BryantSuen/ultrasonic_distance/report/预习报告.pdf

# 预习报告

王晨宇孙博然

2021 年 6 月 27 日

## 1 发送电路

### 1.1 电路图

电路初步设计如图所示


图 1: 发送电路图

采用摆率较大的 LF347 放大器，同相放大，放大倍数设置为 3。LF347 需要接 10V 电源。

1.2 仿真结果 | 预习报告 | 2 接收电路

### 1.2 仿真结果


图 2: 发送电路仿真结果

## 2 接收电路

如图所示

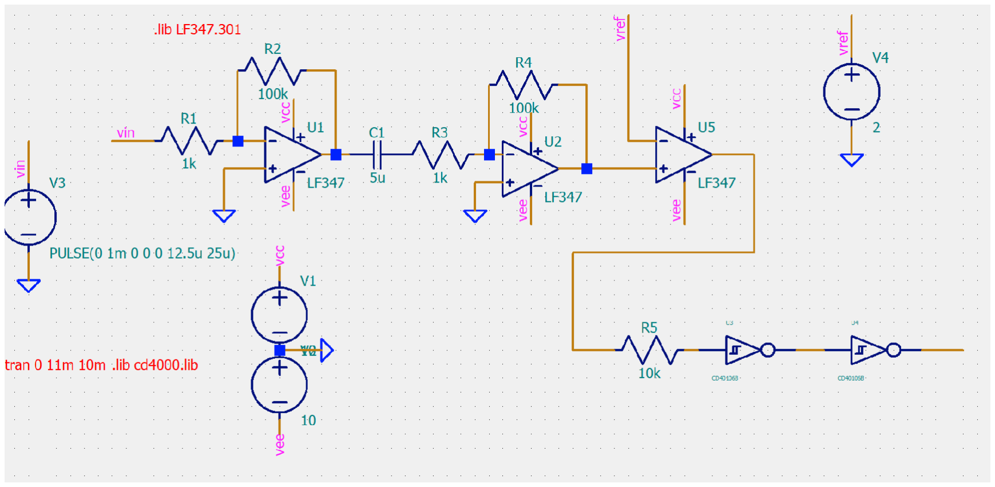
[picture p24: figure]

图 3: 接收电路图

考虑到增益 LF347 增益带宽积，采用两级反相放大，中间添加电容去除直流分量。比较器 Vref 暂时定位 2V，之后连接匹配整形电路。

2.1 仿真结果 | 预习报告 | 3 脉冲产生、计数与显示

### 2.1 仿真结果


图 4: 接收电路仿真结果

CD40106 饱和电压设置 3.3V(与 fpga 相连接)。

## 3 脉冲产生、计数与显示

### 3.1 电路图


图 5: 脉冲产生、计数与显示电路

3.2 仿真结果 | 预习报告 | 3 脉冲产生、计数与显示

### 3.2 仿真结果

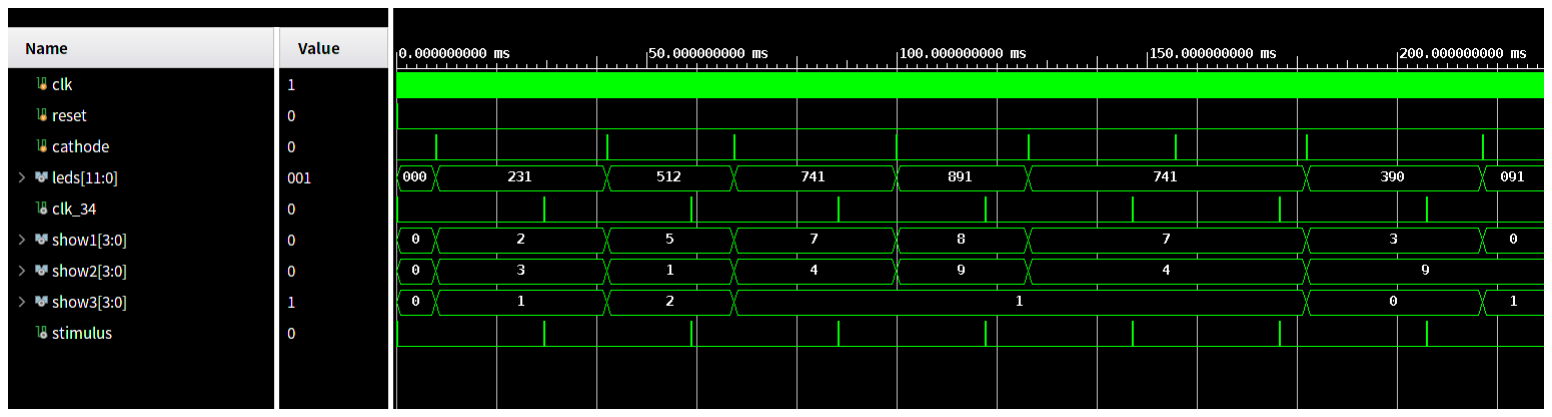
[picture p25: figure]

图 6: 仿真结果
