BryantSuen/ultrasonic_distance/digital_design/sources_1/new/schematic.pdf

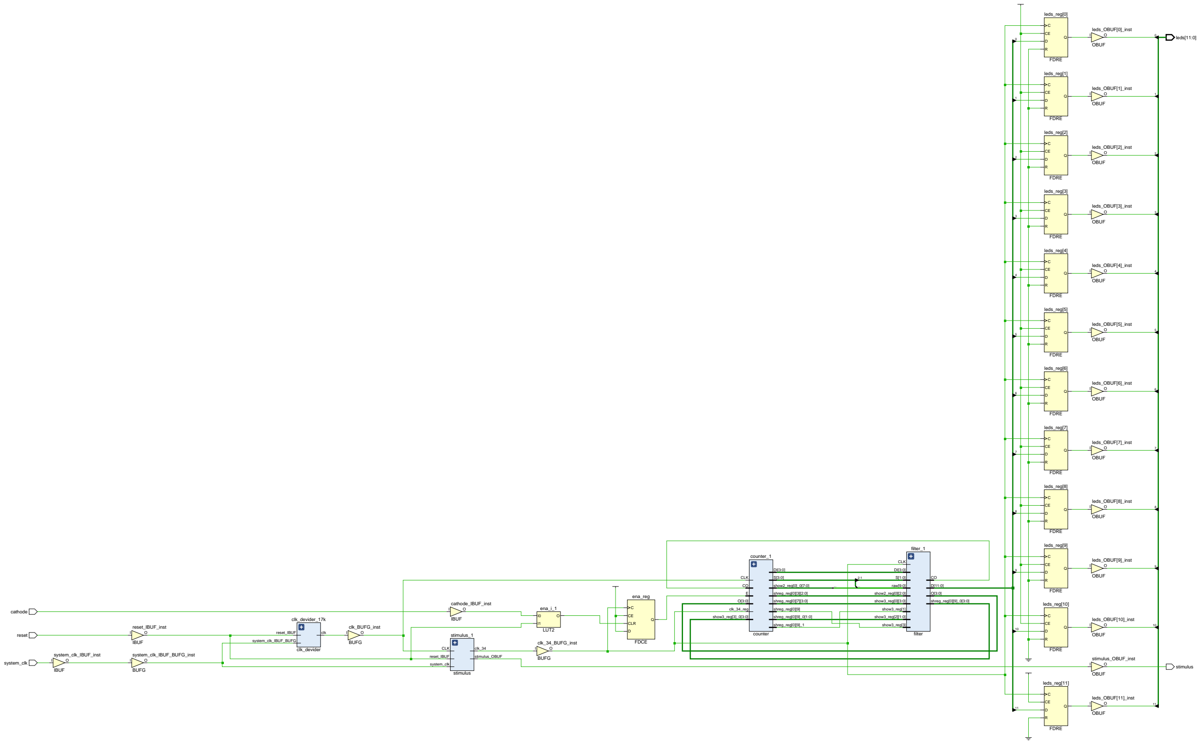
[picture p26: figure]
cathode; reset; system_clk; system_clk_IBUF_inst; IBUF I; reset_IBUF_inst; system_clk_IBUF_BUFG_inst; BUFG I; clk_devider_17k; clk_devider; reset_IBUF; clk; system_clk_IBUF_BUFG; clk_BUFG_inst; cathode_IBUF_inst; stimulus_1; stimulus; CLK; clk_34; stimulus_OBUF; ena_i_1; LUT2; clk_34_BUFG_inst; ena_reg; FDCE; C CECLR D; counter_1; counter; clk_34_reg; S[3:0] show2_reg[0]_0[7:0]; show3_reg[3]_0[3:0]; shreg_reg[0][3][2:0] shreg_reg[0][7][3:0] shreg_reg[0][9] shreg_reg[0][9]_0[1:0] shreg_reg[0][9]_1; filter_1; filter; shreg_reg[0][9]_0[3:0]; leds_reg[0]; FDRE; C CEDR; leds_reg[1]; leds_reg[2]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

raw[9:0] show2_reg[0][2:0] show3_reg[0][3:0] show3_reg[1] show3_reg[2][1:0] show3_reg[3]
