BryantSuen/ultrasonic_distance/报告/assets/图表1电路设计框图.png

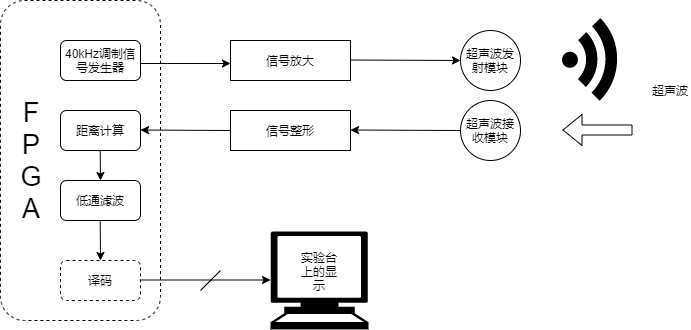
报告/assets/图表1电路设计框图.png
