BryantSuen/ultrasonic_distance/报告/assets/图表3发射电路仿真信号波形.png

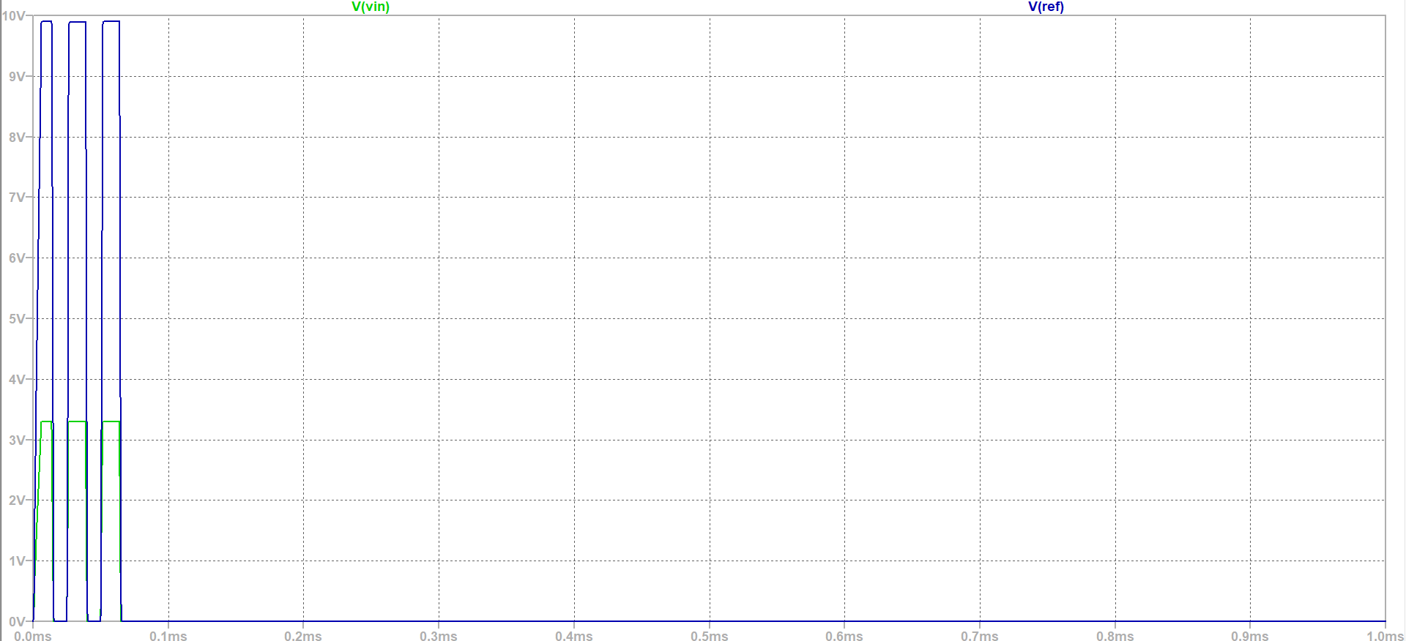
报告/assets/图表3发射电路仿真信号波形.png
