BryantSuen/ultrasonic_distance/报告/assets/图表5经过两级放大的信号（绿）以及通过整形的信号（蓝）.png

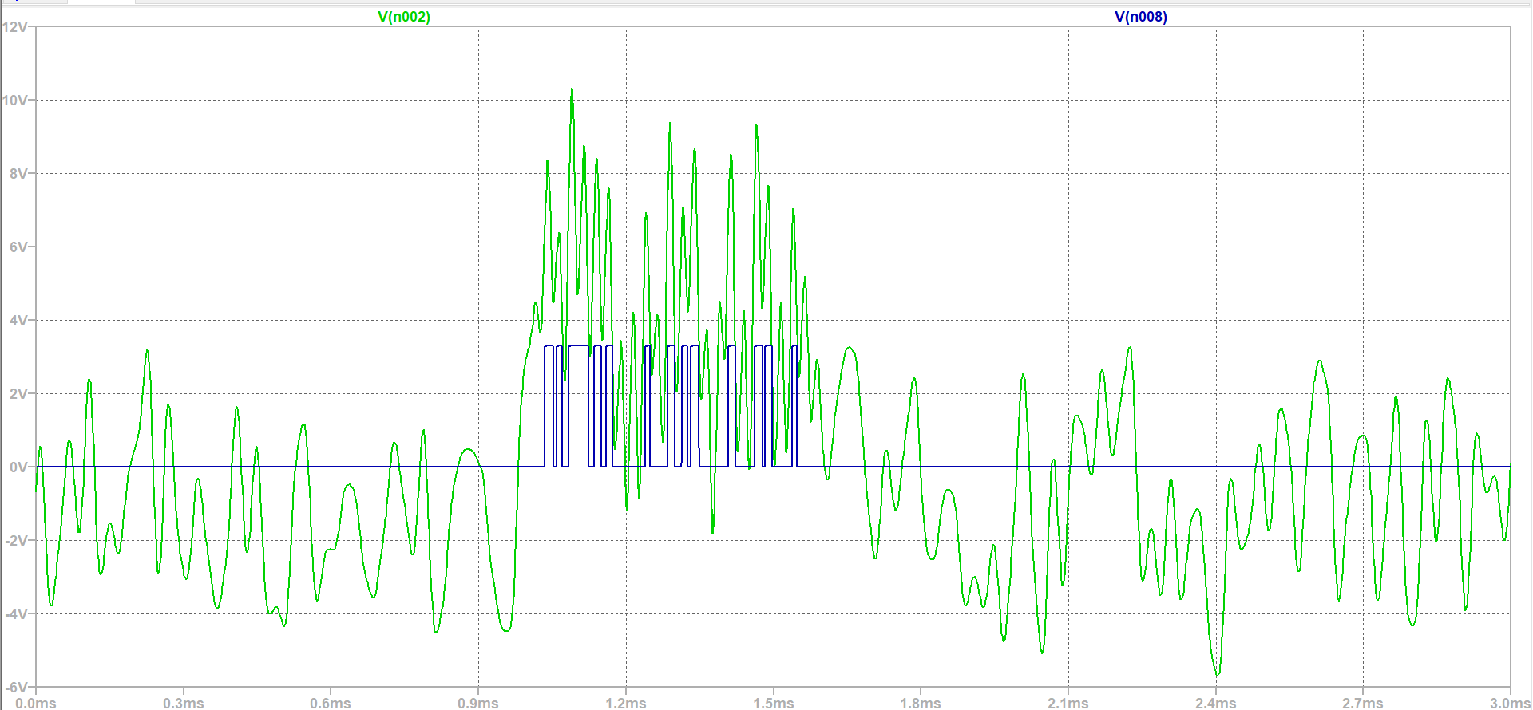
报告/assets/图表5经过两级放大的信号（绿）以及通过整形的信号（蓝）.png
