BryantSuen/ultrasonic_distance/报告/assets/图表8脉冲调制模块.jpg

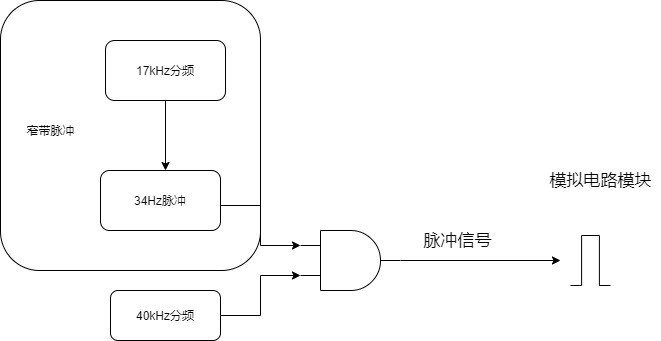
报告/assets/图表8脉冲调制模块.jpg
