BryantSuen/ultrasonic_distance/报告/assets/图表10功能前仿.png

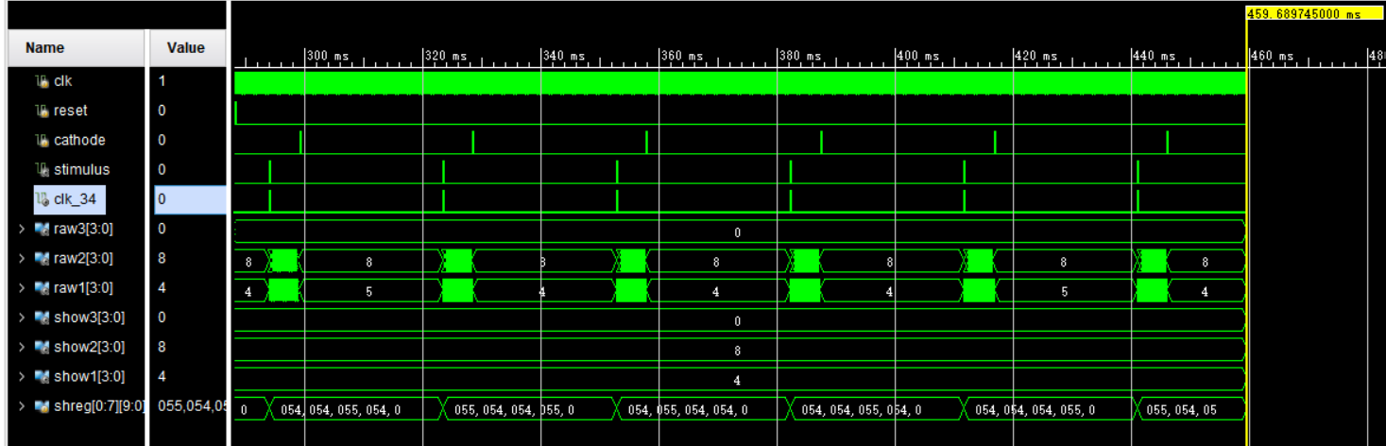
报告/assets/图表10功能前仿.png
