BryantSuen/ultrasonic_distance/报告/assets/图表12 数字电路资源占用情况.png

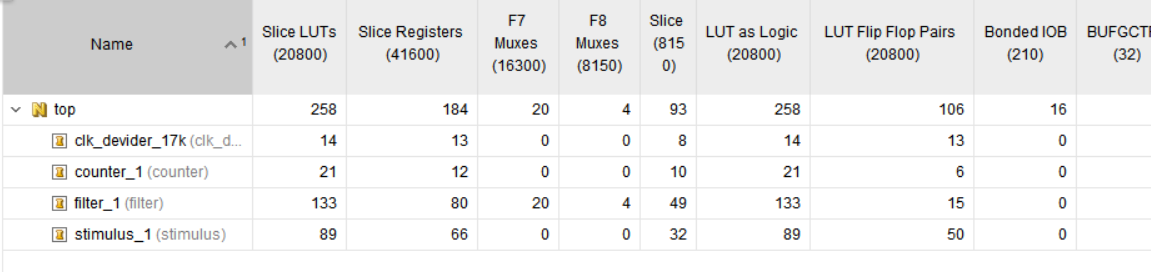
报告/assets/图表12 数字电路资源占用情况.png
