BryantSuen/ultrasonic_distance/报告/assets/图表13发射波形.png

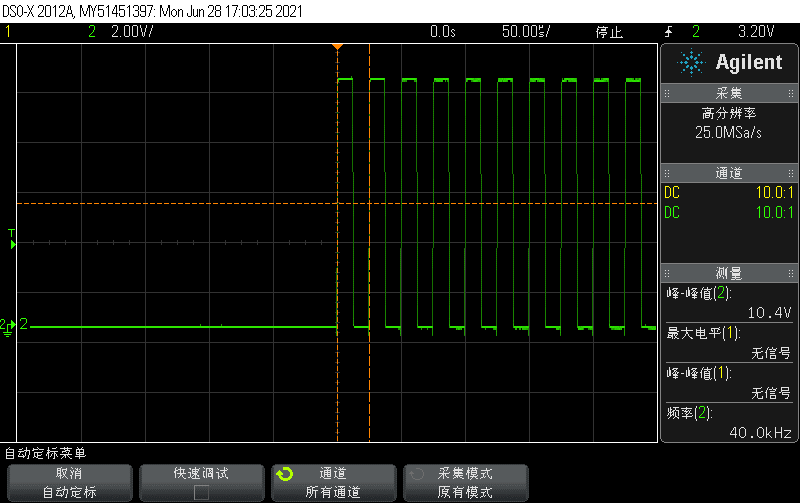
报告/assets/图表13发射波形.png
