BryantSuen/ultrasonic_distance/报告/assets/图表14回波放大.png

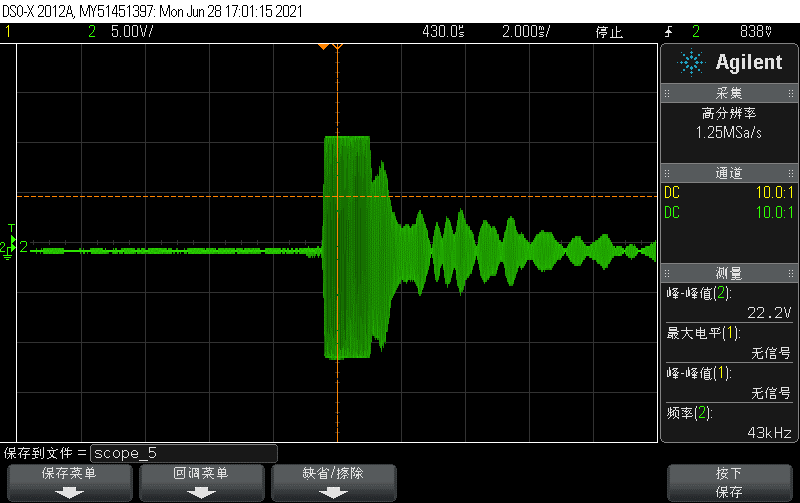
报告/assets/图表14回波放大.png
