BryantSuen/ultrasonic_distance/报告/assets/图表15整形波形.png

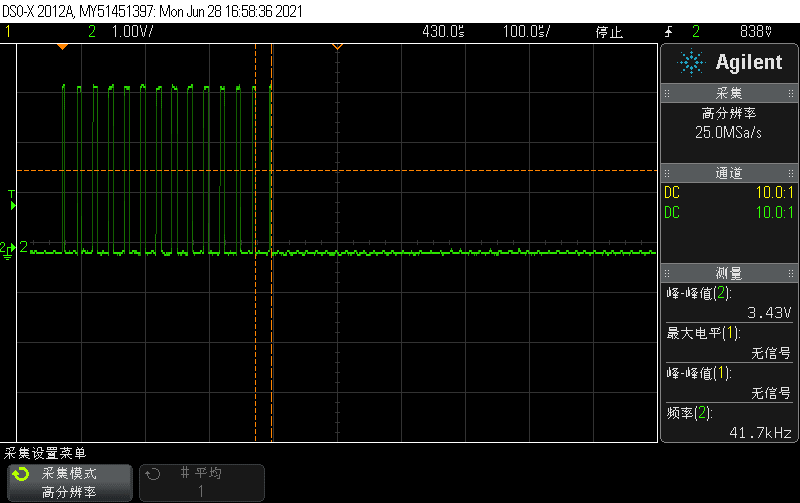
报告/assets/图表15整形波形.png
