BryantSuen/ultrasonic_distance/报告/assets/图表16过比较器(输入FPGA的最终波形).png

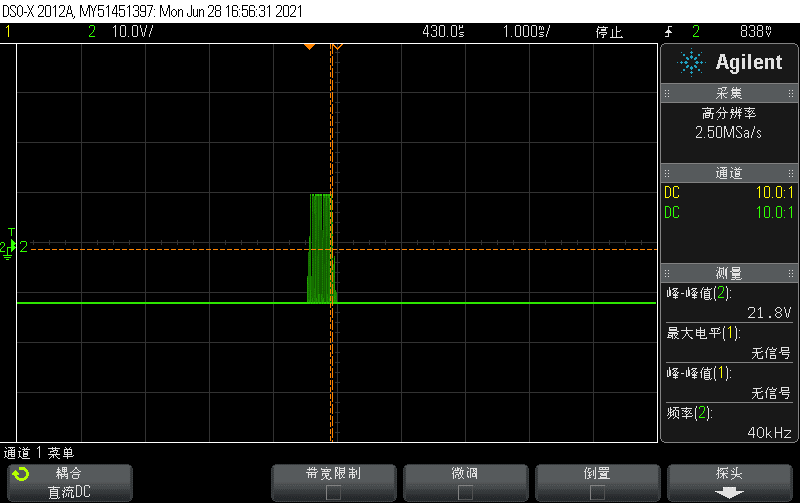
报告/assets/图表16过比较器(输入FPGA的最终波形).png
