BryantSuen/ultrasonic_distance/报告/assets/图表17 50cm显示情况.jpg

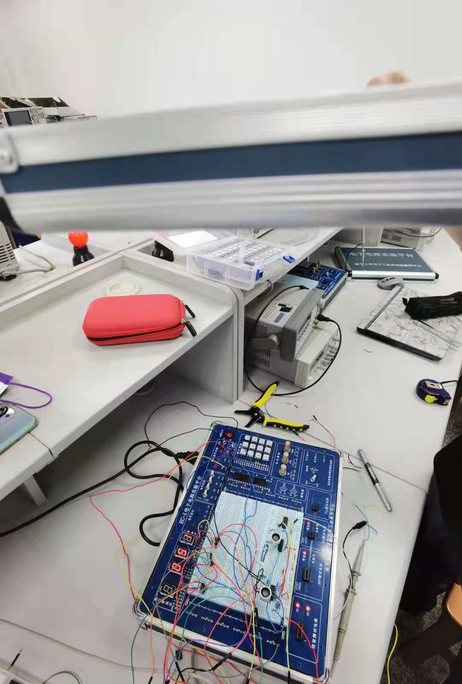
报告/assets/图表17 50cm显示情况.jpg
