BryantSuen/ultrasonic_distance/报告/assets/图表18 200cm显示情况.jpg

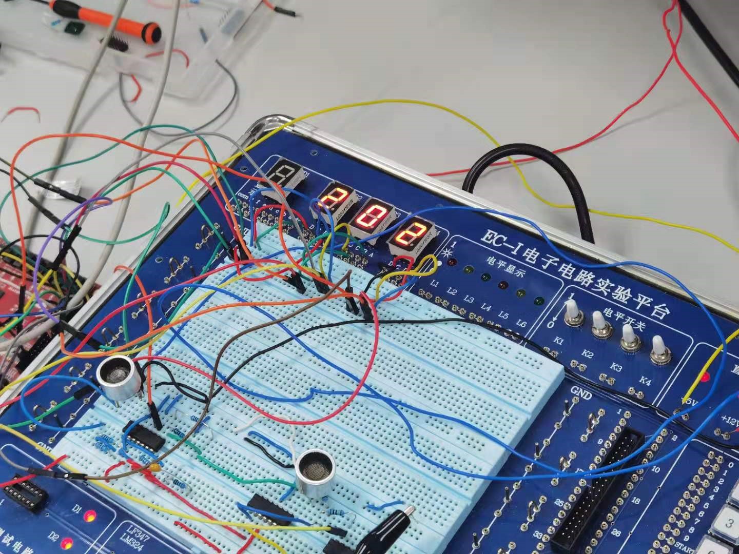
报告/assets/图表18 200cm显示情况.jpg
