BryantSuen/ultrasonic_distance/报告/design file/analog_design/rx.asc

C1: cap; 1u
R1: res; 1k
R2: res; 100k
R3: res; 1k
R4: res; 100k
R5: res; 10k
U1: opamp2; LF347
U2: opamp2; LF347
U3: CD40106B; VDD=3.3  SPEED=1.0  TRIPDT=5e-9
U4: CD40106B; VDD=3.3  SPEED=1.0  TRIPDT=5e-9
U5: opamp2; LF347
V1: voltage; 10
V2: voltage; 10
V3: voltage; PULSE(0 1m 0 0 0 12.5u 25u)
V4: voltage; 2
Named nets: 0, vcc, vee, vin, vref
.lib LF347.301
.tran 0 7m 6m
.lib cd4000.lib
