BryantSuen/ultrasonic_distance/报告/design file/analog_design/tx.asc

B1: bv; V=V(v1)*V(v2)
R1: res; 1k
R2: res; 1k
U1: opamp2; LF347
V1: voltage; PULSE(0 3.3 0 0 0 12.5u 25u)
V2: voltage; 12
V3: voltage; 12
V4: voltage; PULSE(0 1 0 0 0 0.0588m 0.0294)
Named nets: vcc, vee, vin, 0, REF, v1, v2
.lib LF347.301
.tran 1m
