BryantSuen/ultrasonic_distance/digital_design/constrs_1/new/untrasound_demo2.xdc

set_property -dict {PACKAGE_PIN P17 IOSTANDARD LVCMOS33} [get_ports {system_clk}]
create_clock -period 10.000 -name system_clk -waveform {0.000 5.000} [get_ports system_clk]

set_property -dict {PACKAGE_PIN U4 IOSTANDARD LVCMOS33} [get_ports {reset}]

set_property -dict {PACKAGE_PIN E15 IOSTANDARD LVCMOS33} [get_ports {stimulus}]
set_property -dict {PACKAGE_PIN E16 IOSTANDARD LVCMOS33} [get_ports {cathode}]
set_property CLOCK_DEDICATED_ROUTE FALSE [get_nets cathode]

set_property -dict {PACKAGE_PIN B16 IOSTANDARD LVCMOS33} [get_ports {leds[0]}]
set_property -dict {PACKAGE_PIN B17 IOSTANDARD LVCMOS33} [get_ports {leds[1]}]
set_property -dict {PACKAGE_PIN A15 IOSTANDARD LVCMOS33} [get_ports {leds[2]}]
set_property -dict {PACKAGE_PIN A16 IOSTANDARD LVCMOS33} [get_ports {leds[3]}]
set_property -dict {PACKAGE_PIN A13 IOSTANDARD LVCMOS33} [get_ports {leds[4]}]
set_property -dict {PACKAGE_PIN A14 IOSTANDARD LVCMOS33} [get_ports {leds[5]}]
set_property -dict {PACKAGE_PIN B18 IOSTANDARD LVCMOS33} [get_ports {leds[6]}]
set_property -dict {PACKAGE_PIN A18 IOSTANDARD LVCMOS33} [get_ports {leds[7]}]
set_property -dict {PACKAGE_PIN F13 IOSTANDARD LVCMOS33} [get_ports {leds[8]}]
set_property -dict {PACKAGE_PIN F14 IOSTANDARD LVCMOS33} [get_ports {leds[9]}]
set_property -dict {PACKAGE_PIN B13 IOSTANDARD LVCMOS33} [get_ports {leds[10]}]
set_property -dict {PACKAGE_PIN B14 IOSTANDARD LVCMOS33} [get_ports {leds[11]}]
