BryantSuen/ultrasonic_distance/(commit log)

2021-06-27 add analog circuit
2021-06-27 Create 占位置2333
2021-06-27 删了没有用的clk_1k
2021-07-02 菜鸡终于会用一点点git了
2021-07-18 报告写好了
